flatmax/StereoAudioBreakouts/README.md

This repo has moved to :

https://github.com/flatmax2/StereoAudioBreakouts
