flatmax/StereoAudioBreakouts/(commit log)

2017-11-02 Audio injector stereo breakouts V1.8
    [AudioInjectorBreakouts-B.Cu.gbl, AudioInjectorBreakouts-B.Mask.gbs, AudioInjectorBreakouts-B.Paste.gbp, AudioInjectorBreakouts-B.SilkS.gbo, AudioInjectorBreakouts-Edge.Cuts.gm1, AudioInjectorBreakouts-F.Cu.gtl, AudioInjectorBreakouts-F.Mask.gts, AudioInjectorBreakouts-F.Paste.gtp]
2017-11-04 Added PCB mounting holes.
    [AudioInjectorBreakouts-B.Cu.gbl, AudioInjectorBreakouts-B.Mask.gbs, AudioInjectorBreakouts-B.Paste.gbp, AudioInjectorBreakouts-B.SilkS.gbo, AudioInjectorBreakouts-Edge.Cuts.gm1, AudioInjectorBreakouts-F.Cu.gtl, AudioInjectorBreakouts-F.Mask.gts, AudioInjectorBreakouts-F.Paste.gtp]
2018-01-11 moved to flatmax2
    [AudioInjectorBreakouts-B.Cu.gbl, AudioInjectorBreakouts-B.Mask.gbs, AudioInjectorBreakouts-B.Paste.gbp, AudioInjectorBreakouts-B.SilkS.gbo, AudioInjectorBreakouts-Edge.Cuts.gm1, AudioInjectorBreakouts-F.Cu.gtl, AudioInjectorBreakouts-F.Mask.gts, AudioInjectorBreakouts-F.Paste.gtp]
